kwiecinski/Polymerization-lamp-for-dentistry/pictures/poly lamp 1/PCB bottom poly lamp V1.0.jpg

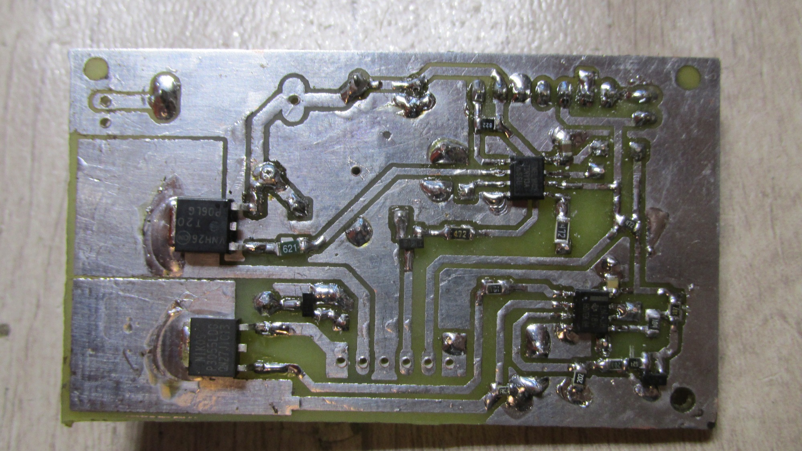
pictures/poly lamp 1/PCB bottom poly lamp V1.0.jpg
