kwiecinski/Polymerization-lamp-for-dentistry/pictures/poly lamp 1/IMG_1927.JPG

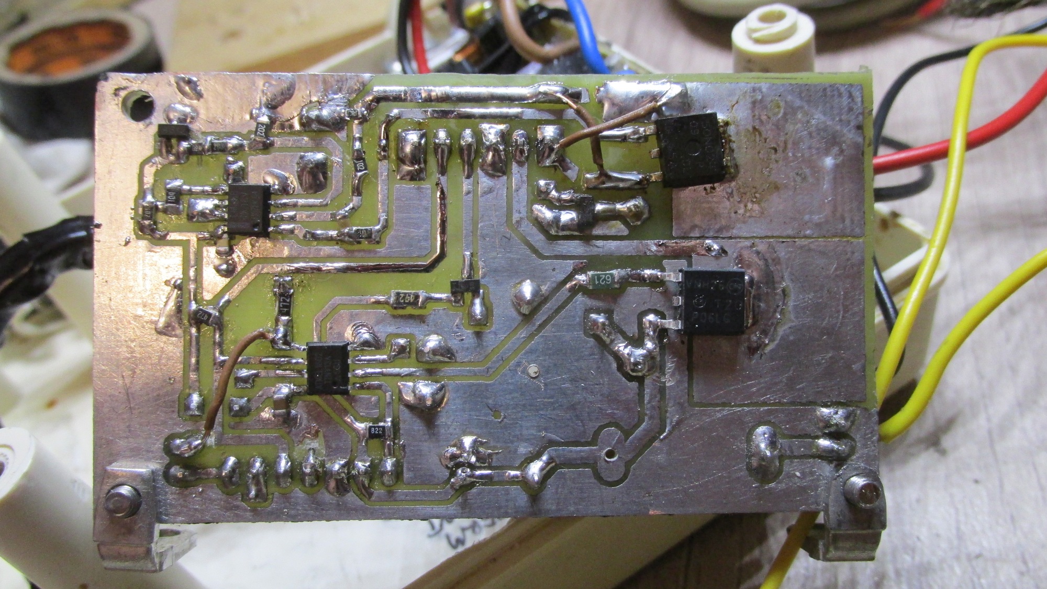
pictures/poly lamp 1/IMG_1927.JPG
