kwiecinski/Polymerization-lamp-for-dentistry/doc/lampa1.docx

Przeróbka stomatologicznej lampy polimeryzacyjnej halogenowej na lampę diodową - Coltene Coltolux II

W stomatologii podczas leczenia ubytków zębowych możemy skorzystać z różnych materiałów do wypełniania. Jednymi z nich są plomby z materiału światło utwardzalnego.

Aby doszło do uwarzenia kompozytu, musi on zostać poddany działaniu światła o określonej długości fali zakresie 430 nm-450nm oraz intensywności świetlnej.

Lampa poddana przeróbce to Coltene Coltolux II

Przeróbka została zastosowana ze względu na uszkodzenie lampy (paliła bardzo często żarówki, o które coraz trudniej i są one drogie).

Dlatego lampa została przerobiona na diodową.

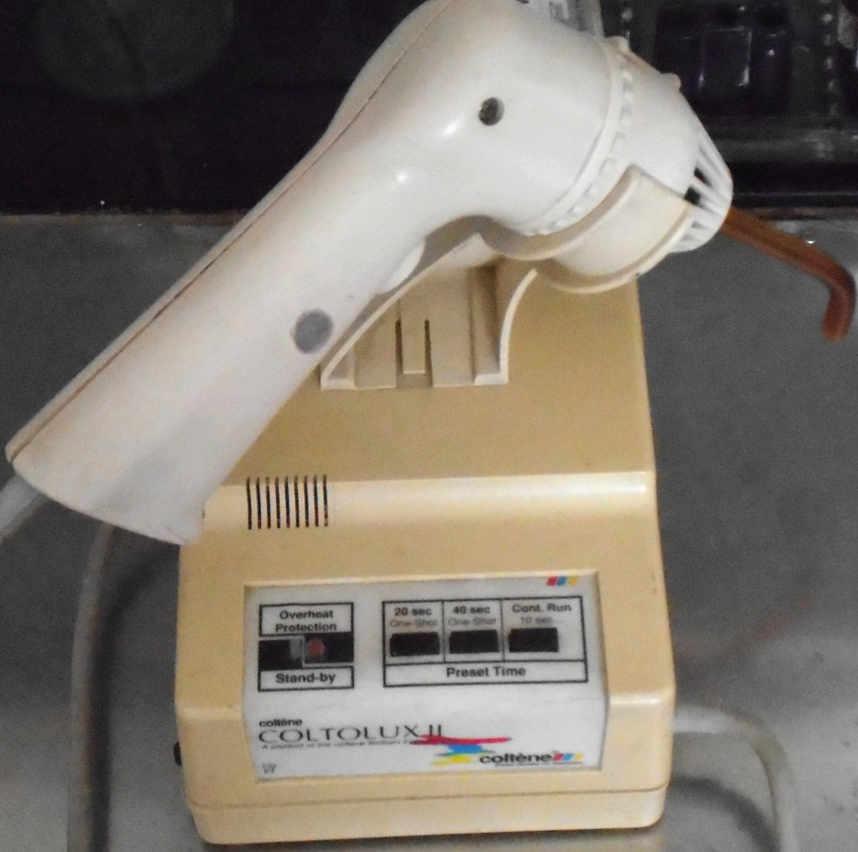
[picture p11: figure]

Poddana przeróbce lampa to Coltene Coltolux II

Aby zrozumieć istotę przeróbki został przegotowany schemat blokowy. Znajduje się na nim:

- przetwornica impulsowa 230V AC → 12V/1,5A DC
- przetwornica DC/DC obniżająca napięcie 12V → 5V
- źródło prądowe z napięciem odniesienia
- mikroprocesor Attiny13A sterujący źródłem prądowym, buzzerem oraz wentylatorem

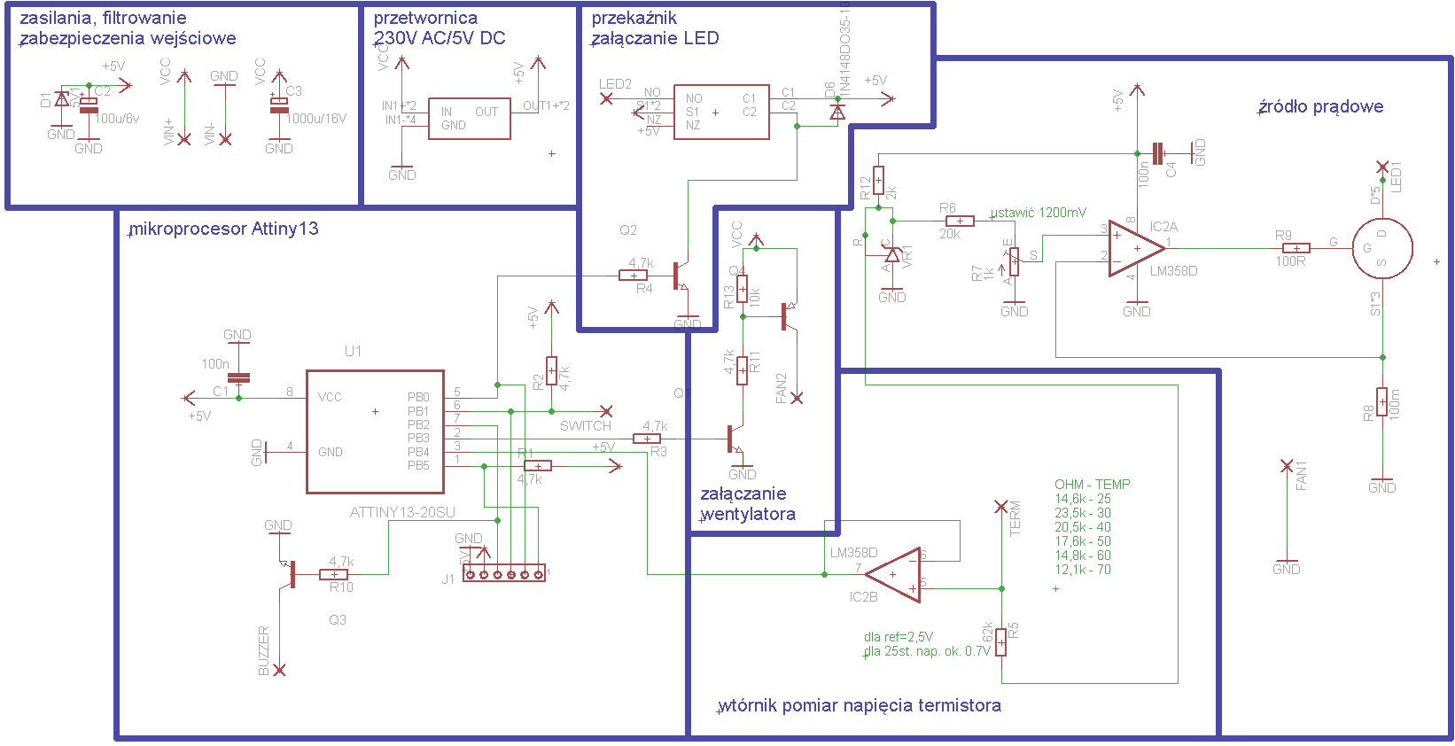
[picture p12: figure]
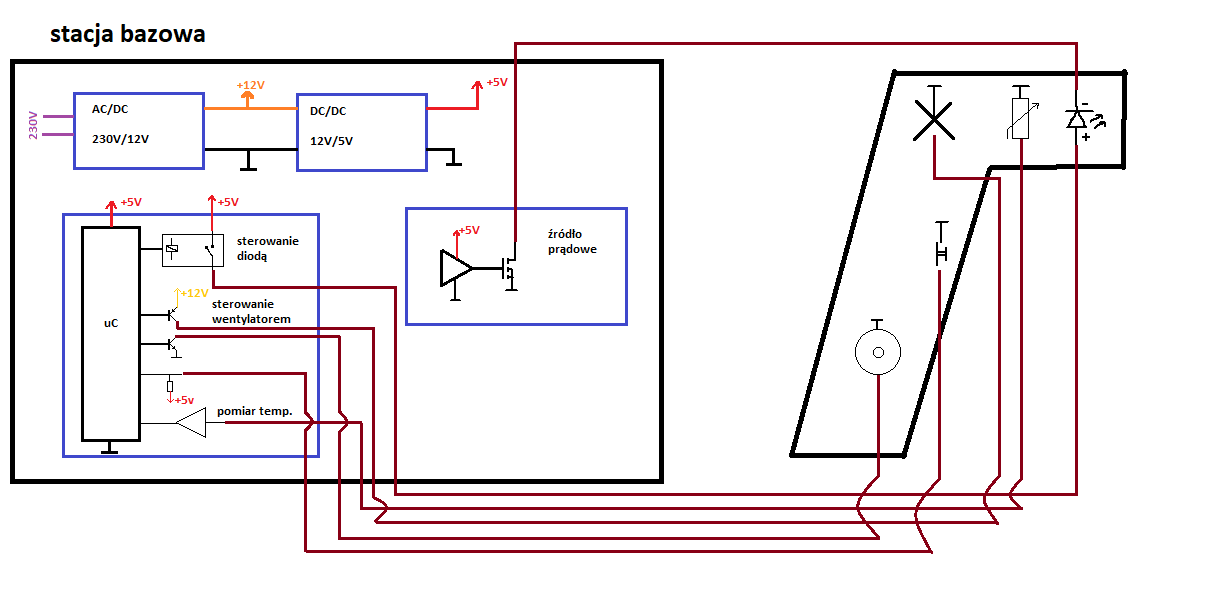
[picture p13: figure]

Schemat blokowy połączeń modułów w lampie

1. Płytka mikroprocesora

Do analizy układu, wykorzystany został zamieszczony poniżej schemat układu. Użyty mikroprocesor to Attiny13A. Na PCB znajduje się złącze do programatora (ISP). Cały układ zasilany jest bezpośrednio z przetwornicy impulsowej AC/DC (5V).

- PB0: sterowanie przekaźnikiem (podanie +5V na anodę diody).

- PB1: przycisk (zwieranie do masy -> włączenie) rezystor pull-up R2

- PB2: wyjście na tranzystor sterujący buzzerem

- PB3: wentylator sterowanie

- PB4: pomiar napięcia termistora

- PB5: reset z rezystorem podciągającym.

Dioda zenera D1 (5V1) służy jako zabezpieczenie przed odwrotnym podaniem napięcia oraz zbyt jego wysokim poziomem.

Schemat układu sterującego – mikroprocesor Attiny13

2. Źródło prądowe

Użyta aplikacja to kanoniczna postać źródła prądowego ze wzm. operacyjnym i tranzystorem. Ze względu na to że napięcie zasilania wynosi 5V natomiast dioda pracuje w optymalnych warunkach na ok. 3.2V zastosowany został tranzystor MOSFET. W przypadku zastosowania bipolarnego spadek napięcia byłby zbyt duży. Jako napięcie odniesienia zastosowany został popularny TL431 (2,5V).

Potencjometrem R7=1k ustawione zostało napięcie które odpowiada prądowi przepływającemu przed diodę. Rezystor R2=0,1R jest rezystorem pomiarowym.

Układ jest teoretycznie OK ale wzmacniacz operacyjny nie lubi obciążeń pojemnościowych i źle może współpracować z pojemnością bramki tranzystora MOSFET. Prawie na pewno znajdą się takie warunki, przy których rezystancja wyjściowa wzmacniacza połączona z pojemnością wejściową MOSFETa dadzą przesunięcie fazy 180 stopni. Drugie 180 dołoży wzmacniacz (od wejścia odwracającego) i otrzymujemy genenerator (układ będzie się wzbudzał). Dlatego został dołożony opornik szeregowo z bramką (100R).


Schemat źródła prądowego


3. Dioda LED

Ponieważ do utwardzenia niezbędne jest promieniowanie UV o określonej długości fali, została użyta specjalna dioda LED. Można by zastosować diodę LED o świetle normalnym ponieważ lampa zawiera filtr który na wyjście dopuści tylko światło o określonej długości, ale wolałem zastosować specjalistyczną diodę której cała moc będzie o określonej barwie światła.

Kolor | UV- ultrafiolet
Moc | 3W
Chip | 45mil x 45mil Taiwan
Napięcie pracy | 3.3V - 3.6V
Max. prąd przewodzenia | 700mA
Długość Fali | 430 - 435 nm
Kąt świecenia | 140 stopni

4. Analiza programu

W tej części omówię ważniejsze części programu. Resztę opisu znajduje się w komentarzach w programie.

- ustawienie przerwania od przycisku

MCUCR |= (1<<ISC01)|(1<<ISC00);

GIMSK |= (1<<INT0);

GIFR |= (1<INTF0);

Rejestr MCUCR - rejestr kontroli mikrokontrolera, zawiera między innymi bity kontrolne do wyboru sposobu wykrywania przerwania INT0 i INT1.

Gdy określimy sposób generowania przerwana, musimy uaktywnić przerwanie przez ustawienie na 1 bitu INT0 w rejestrze GIMSK (ang. General Interrupt Mask Register – rejestr maskowania przerwań zewnętrznych)

Z przerwaniami zewnętrznymi związany jest jeszcze rejestr znaczników przerwań GIFR. Ma on podobną budowę do rejestru GIMSK, który maskuje (tzn. uaktywnia lub blokuje) przerwania zewnętrzne na tych samych bitach. Bity INTF0 i PCIF zostają ustawione na 1, gdy wystąpi warunek przerwania INT lub PCINT. Jeśli zostanie przy tym wywołana procedura ISR danego przerwania, to odpowiedni bit rejestru znaczników przerwań zostanie automatycznie wyzerowany.

-ustawienie przerwania od timera

Timer pracuje w trybie CTC, licznik zlicza od 0 do OCR0A i potem znów od zera. Generuje przerwanie w wektorze ISR(TIM0_COMPA_vect) co około 0,1s.

OCR0A = 94; //rejest porównania timera - max 255 (dla 94 – 0,1s 100 Hz)

TCCR0A |= (1 << WGM01); //Tryb CTC

TCCR0B |= (1 << CS02)|(1 << CS00); //clock select - clk/1024

TIMSK0 |= (1 << OCIE0A); //włączenie timera

- przerwanie od przycisku

Obsługa przerwania następuje w wektorze ISR(INT0_vect).

Instrukcja GIFR|=(0<INTF0); czyli wyłączenie przerwania, została dodana ponieważ następowało niepożądane wyzwalanie przerwania podczas jego działania co objawiało się naprzemiennym włączaniem i wyłączaniem lampy.

ISR(INT0_vect) //przerwanie od INT0 - switch do włączania LED obsługiwany w przerwaniu

{

GIFR|=(0<INTF0);

if (flaga==0)

{

led_on;

buzz_on;

_delay_ms(20);

buzz_off;

flaga=1;

timer=0;

} else if (flaga>0)

{

led_off;

flaga=0;

buzz_on;

_delay_ms(20);

buzz_off;

}

_delay_ms(50);

GIFR|=(1<INTF0);

}

Lampa czeka na naciśnięcie przycisku. W momencie naciśnięcia program wchodzi w przerwanie zewnętrzne. Włącza led, piknie buzerem na włączenie (przez czas 20ms) i ustawi „flaga=1”.

W przypadku ponownego naciśnięcia przycisku, program znów wejdzie w to przerwanie z tym że przejdzie do drugiej części czyli wyłączy led, piknie buzerem na wyłączenie (przez czas 20ms) oraz ustawi „flaga=0” .

- pętla główna

W pętli gównej odbywa się sterowanie buzerem oraz wentylatorem. Po naciśnięciu przycisku włączenia w obsłudze przerwania zewnętrzenego zemini się wartość stanu zmiennej „flaga=1”. Program wyzeruje zmienne zliczania czasu buzera (timer) i wentylatora (fan_timer1, fan_timer2). Zmienna pm1 wprowadzona została aby nie zerować timerów w jednym cyklu świecenia.

if((flaga>0 && pm1==0)==1)

{

timer=0;

fan_timer2=0;

fan_timer1=0;

pm1=1;

W następnej kolejności, progam cały czas sprawdza w pętli czy przekroczone zostały wartości zmiennych timer oraz fan_timer1. Narastają one cały czas w wektorze przerwania timera. Jeśli timer>120 (dobrane dla czasu 10s) nastąpi uruchomienie buzera na 30ms (piknięcie).

Gdy od początku włączenia minie ok. 15sek. nastąpi włączenie wentylatora. Wentylator nie ma sprzężenia zwrotnego w postaci temperatury radiatora i uruchamiany jest gdy lampa chodzi przez ten określony czas (dobrane eksperymentalnie, radiator zaczyna się nagrzewać po chwili). Zmienna „pomocnicza_fan1” została wprowadzona aby po uruchomieniu wentylatora, zatrzasnąć stan jego włączenia, tzn. gdyby w tym czasie naciśnięty został przycisk wentylator nie zostanie wyłączony tylko będzie dalej chłodził radiator.

Zerowana jest zmienna „fan_timer2=0” która odpowiada na naliczanie czasu do wyłączenia wentylatora

else if((flaga>0 && pm1>0)==1)

{

if(timer>120)

{

buzz_on;

_delay_ms(30);

buzz_off;

timer=0;

}

if((fan_timer1>170 && pomocnicza_fan1==0)==1)

{

fan_on;

fan_timer2=0;

pomocnicza_fan1=1;

}

}

Wyłączenie wentylatora następuje po czasie ok. 15s od włączenia.

if(fan_timer2>170)

{

fan_off;

}

- przerwanie od timera

Przerwanie realizowane jest w wektorze ISR(TIM0_COMPA_vect).

ISR(TIM0_COMPA_vect)

{

timer++;

}

5. Dokumentacja fotograficzna

Urządzenie w środku, rozmieszczenie elementów

PCB źródła prądowego

Zastosowana dioda LED wraz z soczewką skupiającą oraz radiatorem
