kwiecinski/Polymerization-lamp-for-dentistry/pictures/poly lamp 1/clean PCB poly lamp V1.0.jpg.jpg

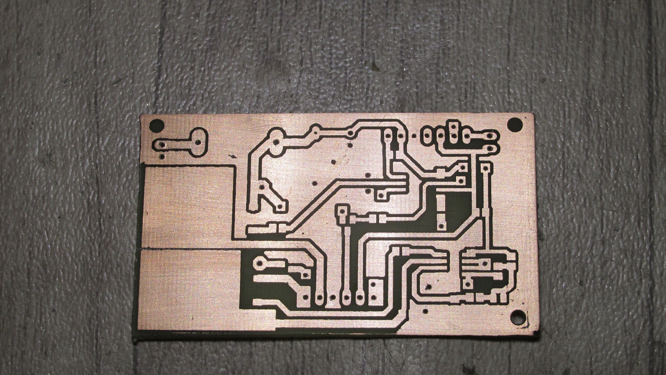
pictures/poly lamp 1/clean PCB poly lamp V1.0.jpg.jpg
