kwiecinski/Polymerization-lamp-for-dentistry/pictures/poly lamp 1/IMG_1915.JPG

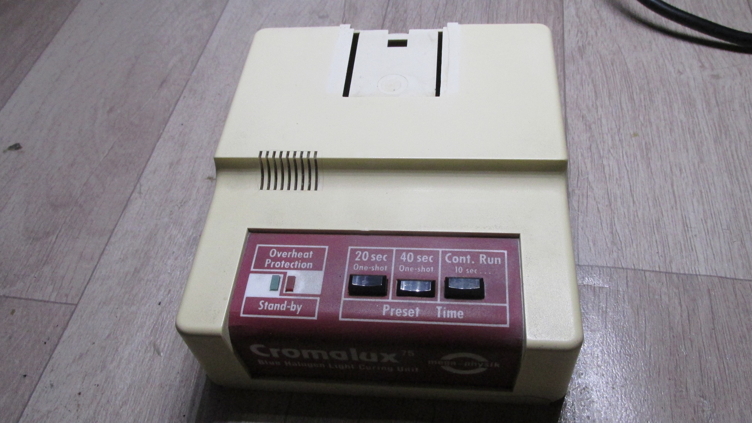
pictures/poly lamp 1/IMG_1915.JPG
