kwiecinski/Polymerization-lamp-for-dentistry/pictures/poly lamp 1/IMG_20190801_221521.jpg

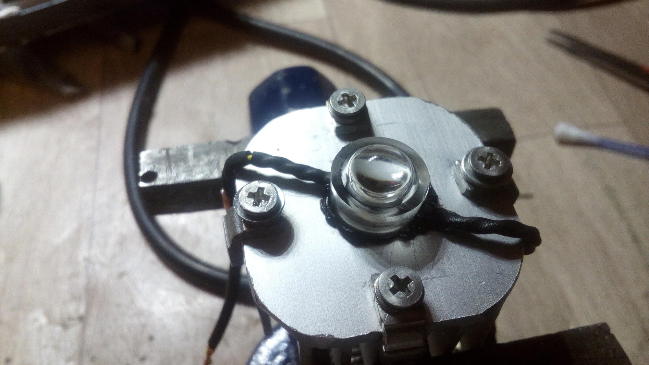
pictures/poly lamp 1/IMG_20190801_221521.jpg
