kwiecinski/Polymerization-lamp-for-dentistry/pictures/poly lamp 1/PCB top poly lamp V1.0.jpg.JPG

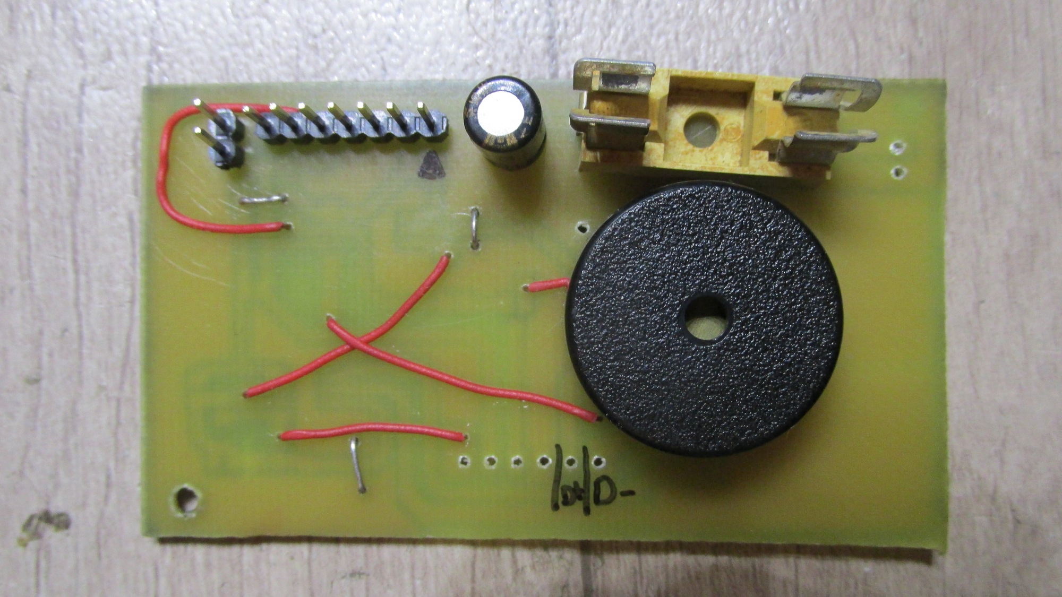
pictures/poly lamp 1/PCB top poly lamp V1.0.jpg.JPG
