kwiecinski/Polymerization-lamp-for-dentistry/PCB/V1.0/poly-lamp-V1.0.brd

## EAGLE design PCB/V1.0/poly-lamp-V1.0.brd (2020-03-01)

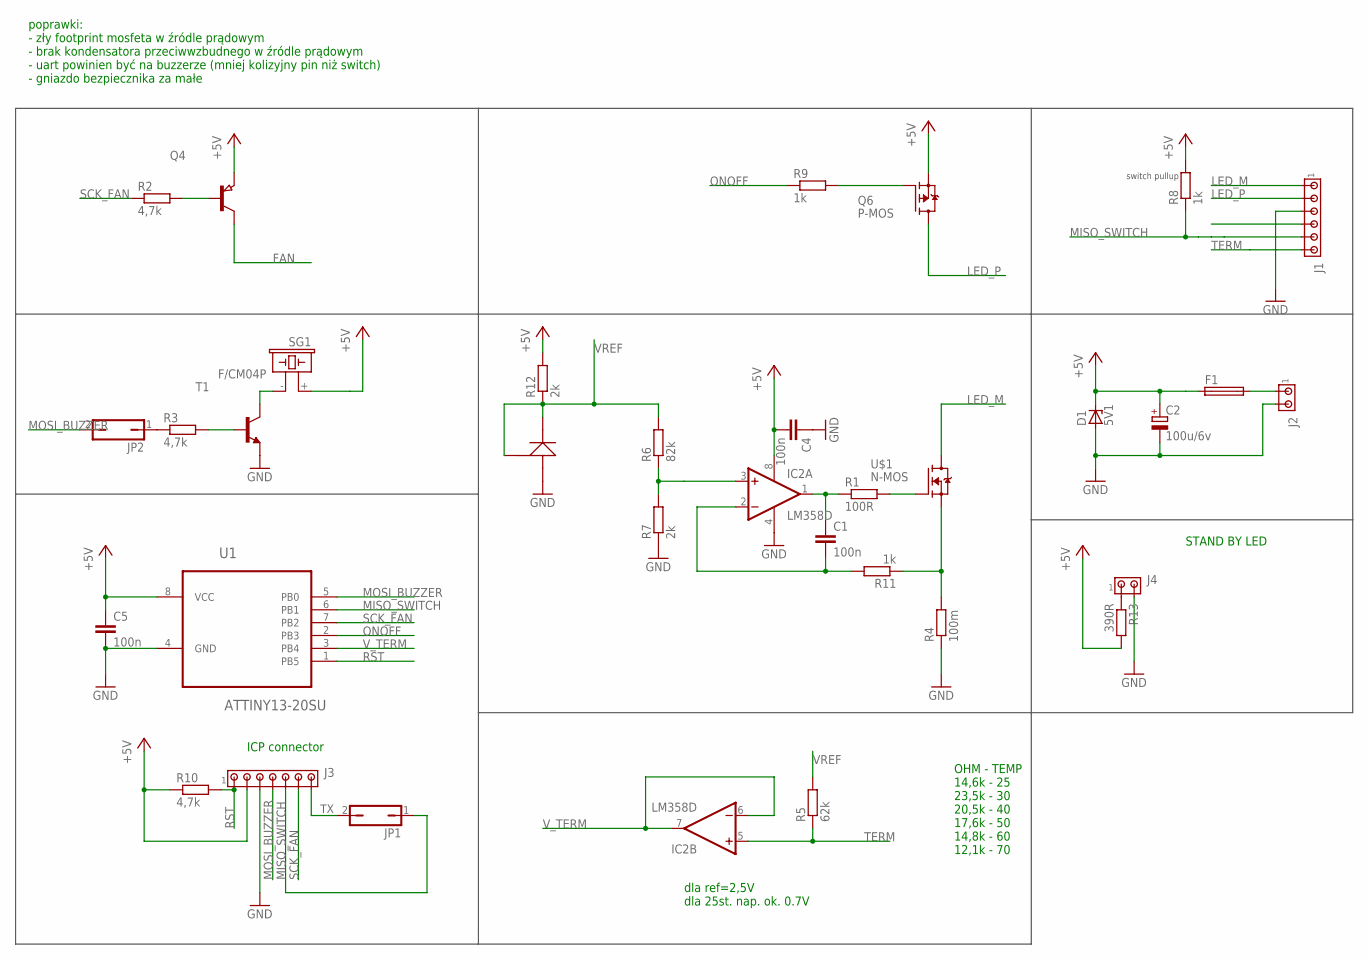
[picture p26: schematic poly-lamp-V1.0.sch]

Parts:
C1, C4, C5: 100n; C0805
C2: 100u/6v; E2,5-7
D1: 5V1; DO35Z10
F1: SH22,5
IC2: LM358D; SO08
J1: MTA06-100; 10X06MTA
J2, J4: MTA02-100; 10X02MTA
J3: MTA07-100; 10X07MTA
JP1, JP2: JP1Q; JP1
Q4: PNP-TRANSISTOR_SOT23; SOT23
Q6: P-MOS; TO252
R1: 100R; R0805
R2, R3, R10: 4,7k; R0805
R4: 100m; R0805
R5: 62k; R0805
R6: 82k; R0805
R7, R12: 2k; R0805
R8, R9, R11: 1k; R0805
R13: 390R; R0805
SG1: F/CM04P
T1: BC817-16-NPN-SOT23-BEC; SOT23-BEC
U1: ATTINY13-20SU; SOIC127P798X216-8N
U$1: N-MOS; TO252
U$2: TL431; SOT23-BEC

Connections:
+5V: C2.+, C4.2, C5.1, D1.C, F1.1, IC2.8 (V+), J3.2, Q4.2 (E), Q6.2 (S), R8.2, R10.1, R12.2, R13.2, SG1.+ (1), U1.8 (VCC)
FAN: J1.4, Q4.3 (C)
GND: C2.-, C4.1, C5.2, D1.A, IC2.4 (V-), J1.3, J2.2, J3.3, J4.2, R4.1, R7.1, T1.E, U1.4 (GND), U$2.C (A)
LED_M: J1.1, U$1.3 (D)
LED_P: J1.2, Q6.3 (D)
MISO_SWITCH: J1.5, J3.5, JP1.1, R8.1, U1.6 (PB1)
MOSI_BUZZER: J3.4, JP2.2, U1.5 (PB0)
unnamed: C1.1, IC2.1 (OUT), R1.1
unnamed: R1.2, U$1.1 (G)
unnamed: R3.2, T1.B
unnamed: SG1.- (2), T1.C
unnamed: Q4.1 (B), R2.2
unnamed: IC2.3 (+IN), R6.1, R7.2
unnamed: C1.2, IC2.2 (-IN), R11.2
unnamed: Q6.1 (G), R9.2
unnamed: F1.2, J2.1
unnamed: JP2.1, R3.1
unnamed: J4.1, R13.1
unnamed: R4.2, R11.1, U$1.2 (S)
ONOFF: R9.1, U1.2 (PB3)
RST: J3.1, R10.2, U1.1 (PB5)
SCK_FAN: J3.6, R2.1, U1.7 (PB2)
TERM: IC2.5 (+IN), J1.6, R5.1
TX: J3.7, JP1.2
VREF: R5.2, R6.2, R12.1, U$2.B (K), U$2.E (R)
V_TERM: IC2.6 (-IN), IC2.7 (OUT), U1.3 (PB4)

Notes on the sheet:
OHM - TEMP 14,6k - 25 23,5k - 30 20,5k - 40 17,6k - 50 14,8k - 60 12,1k - 70
dla ref=2,5V dla 25st. nap. ok. 0.7V
ICP connector
switch pullup
poprawki: - zły footprint mosfeta w źródle prądowym - brak kondensatora przeciwwzbudnego w źródle prądowym - uart powinien być na buzzerze (mniej kolizyjny pin niż switch) - gniazdo bezpiecznika za małe
STAND BY LED

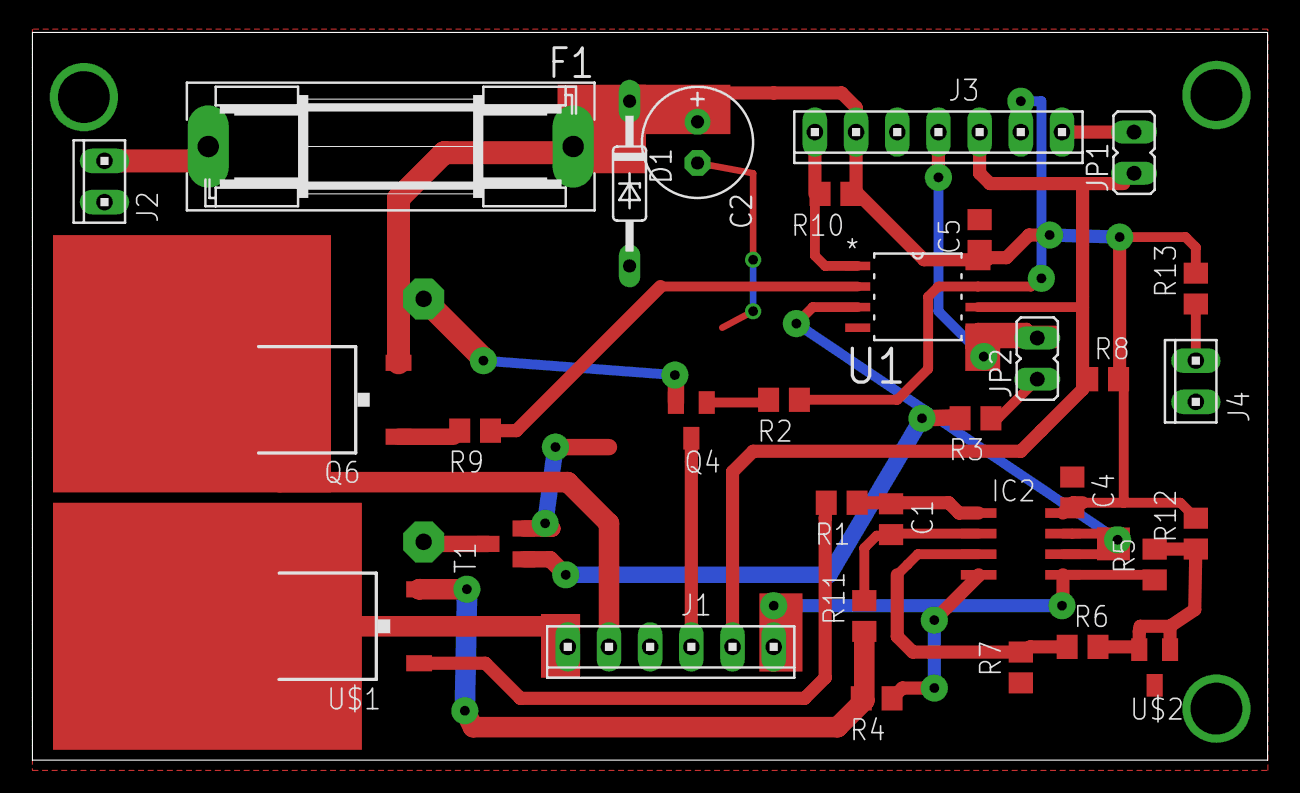
[picture p27: board poly-lamp-V1.0.brd from above]

Board: 2 copper layers, 76.2 x 44.9 mm, 33 parts (1 on the bottom side), 26 nets.
