kwiecinski/Polymerization-lamp-for-dentistry/AVR source code/Code V1.0 for PCB V1.0/main.c

#include <avr/io.h>
#include <avr/interrupt.h>
#include <util/delay.h>
#include "define.h"
#include "ADC.h"
#include "LEDLamp.h"
#include "TimerISR.h"

int main()
{
	MAINSTRUCT LedVar;

	MAIN_Init(&LedVar);

	while(true)
	{
		KeyPress(&LedVar);
		TempCheck(&LedVar);
		BuzzerDrive(&LedVar);
		Buzzer10sCheck(&LedVar);
	}

}
